motekulo/prog1/README.md

# Prog1

A [guitar pedal](https://progpedals.com.au/pedals/) that runs patches prototyped on a Daisy Pod. 

[ProgPedals](https://progpedals.com.au) is the site dedicated to this pedal, patches, and community.

## Thanks

- For hardware thanks to work on the Dasiy Petal, the [Terrarium](https://www.pedalpcb.com/product/pcb351/), [Hothouse](https://clevelandmusicco.com/hothouse-diy-digital-signal-processing-platform-kit/) and the work of  [Keith Shepherd](https://github.com/bkshepherd)
- Timothy Schoen and other developers (Alex Mitchell, for example) for Plugdata
- Wasted Audio for the [Heavy hvcc compiler](https://wasted-audio.github.io/hvcc/)
- Graham Wakefield and Gregory Taylor for [Generating Sound and Organizing Time](https://cycling74.com/books/go)

## Videos

[ProgPedals playlist](https://www.youtube.com/playlist?list=PL_tHhignqT_7VD3HtruWB_GTngK06rujz)

## Roadmap

- Prog2 - using the [Daisy Seed2 DFM](https://electro-smith.com/pages/daisy-seed2-dfm)
- ~~ Footswitch PCBs connected via IDC cable ~~
- ~~ Better audio sockets ~~
- ~~ SMD version as well as through hole. ~~

## About me
I'm a musician/ lecturer - https://researchers.mq.edu.au/en/persons/denis-crowdy, https://codemusic.studio
