motekulo/prog1/hardware/3dmodels/3-D NMJ6HCD2.stp

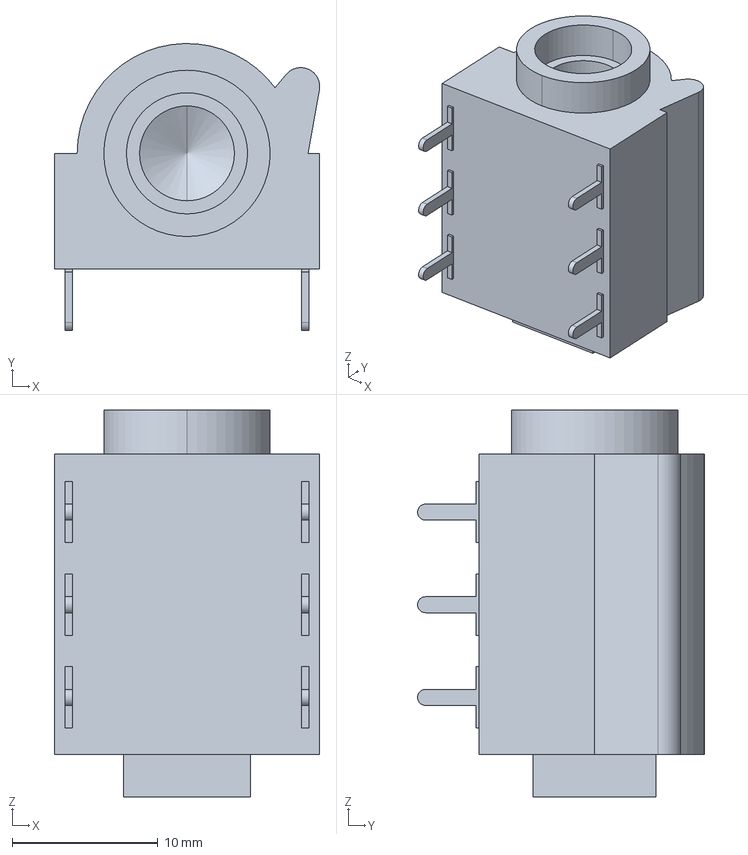
[picture p1: CAD file, 2025-10-05]
hardware/3dmodels/3-D NMJ6HCD2.stp
18.2 x 19.7 x 26.5 mm
