motekulo/prog1/hardware/footprints/stereo_socket/NYS215/3D/NYS215.stp

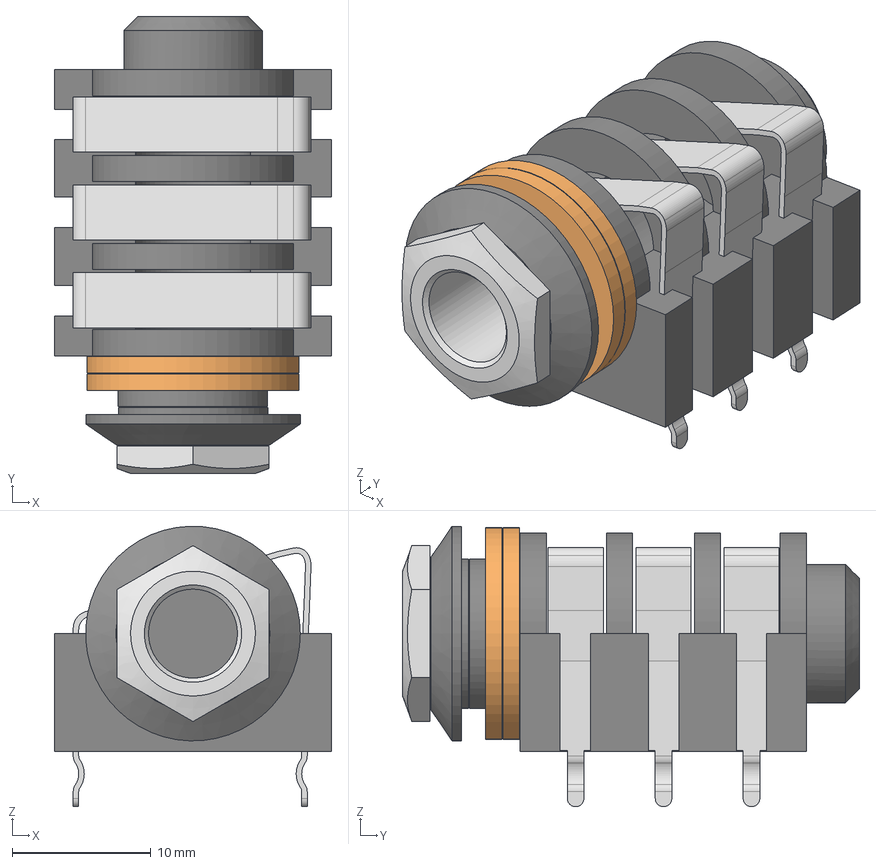
[picture p2: CAD file, 2025-10-05]
hardware/footprints/stereo_socket/NYS215/3D/NYS215.stp
20.0 x 33.0 x 20.2 mm
