motekulo/prog1/hardware/footprints/stompdpdt/SF12011F-0202-20R-M-050/3D/SF12011F-0202-20R-M-050.stp

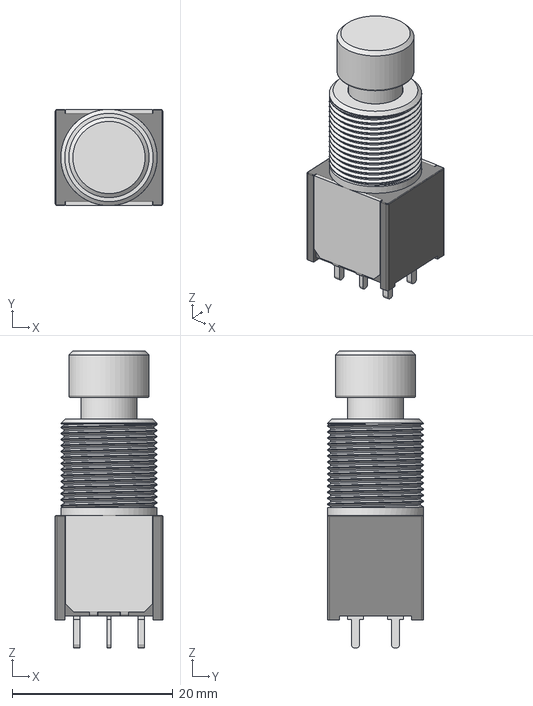
[picture p3: CAD file, 2025-10-04]
hardware/footprints/stompdpdt/SF12011F-0202-20R-M-050/3D/SF12011F-0202-20R-M-050.stp
13.4 x 12.0 x 37.0 mm
