motekulo/prog1/(list of files, cad)

Other CAD files:
hardware/footprints/stereo_socket/NYS215/Allegro/nys215.psm
hardware/footprints/stereo_socket/NYS215/DEHDL/nys215/chips/chips.prt
hardware/footprints/stompdpdt/SF12011F-0202-20R-M-050/Allegro/sf12011f020220rm050.psm
hardware/footprints/stompdpdt/SF12011F-0202-20R-M-050/DEHDL/sf12011f_0202_20r_m_050/chips/chips.prt
