motekulo/prog1/(list of files, drawings)

Other design files:
hardware/footprints/stereo_socket/NYS215/Altium/NYS215.PcbLib
hardware/footprints/stereo_socket/NYS215/Altium/NYS215.SchLib
hardware/footprints/stompdpdt/SF12011F-0202-20R-M-050/Altium/SF12011F020220RM050.PcbLib
hardware/footprints/stompdpdt/SF12011F-0202-20R-M-050/Altium/SF12011F-0202-20R-M-050.SchLib
