motekulo/prog1/hardware/125b/125b.kicad_pcb

## KiCad design hardware/125b/125b.kicad_pcb (2026-09-01)

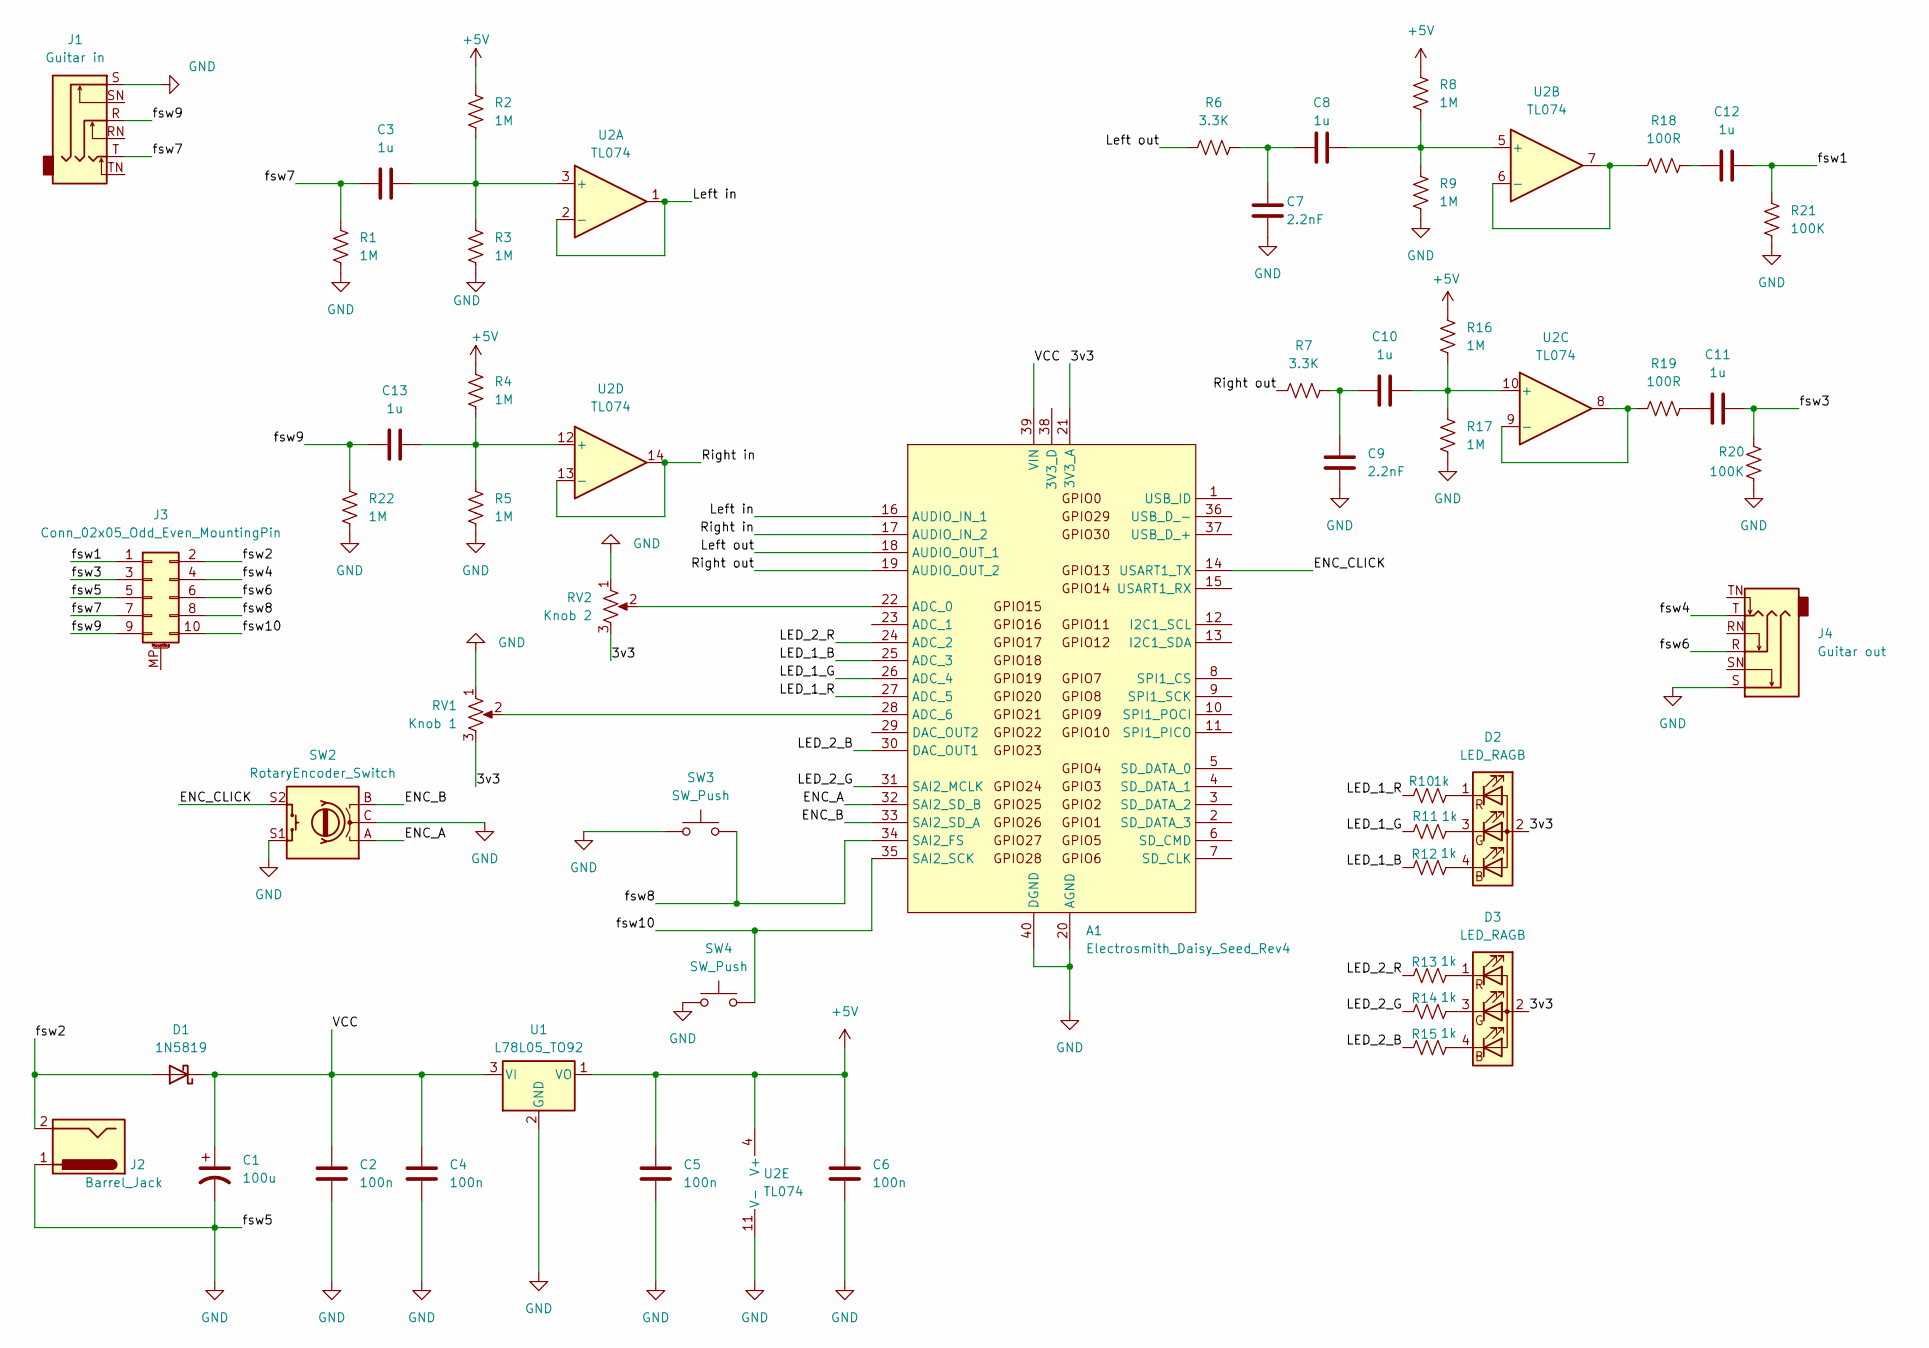
[picture p4: schematic 125b.kicad_sch, Podal]

Parts:
A1: Electrosmith_Daisy_Seed_Rev4; Electrosmith_Daisy_Seed
C1: 100u; C_Radial_D5.0mm_H11.0mm_P2.00mm
C2, C4, C5, C6: 100n; C_0805_2012Metric
C3, C8, C10, C11, C12, C13: 1u; C_0805_2012Metric
C7, C9: 2.2nF; C_0805_2012Metric
D1: 1N5819; D_DO-41_SOD81_P7.62mm_Horizontal
D2, D3: LED_RAGB; LED_D5.0mm-4_RGB_Wide_Pins
J1: Guitar in; Jack_6.35mm_Neutrik_NMJ6HCD2_Horizontal
J2: Barrel_Jack; BarrelJack_Horizontal
J3: Conn_02x05_Odd_Even_MountingPin; IDC-Header_2x05_P2.54mm_Vertical
J4: Guitar out; Jack_6.35mm_Neutrik_NMJ6HCD2_Horizontal
R1, R2, R3, R4, R5, R8, R9, R16, R17, R22: 1M; R_0805_2012Metric
R6, R7: 3.3K; R_0805_2012Metric
R10, R11, R12, R13, R14, R15: 1k; R_0805_2012Metric
R18, R19: 100R; R_0805_2012Metric
R20, R21: 100K; R_0805_2012Metric
RV1: Knob 1; Potentiometer_Alps_RK09K_Single_Vertical
RV2: Knob 2; Potentiometer_Alps_RK09K_Single_Vertical
SW2: RotaryEncoder_Switch; RotaryEncoder_Alps_EC12E-Switch_Vertical_H20mm
SW3, SW4: SW_Push; SolderWire-0.5sqmm_1x02_P4.6mm_D0.9mm_OD2.1mm
U1: L78L05_TO92; TO-92_Inline_Wide_78L05_dc
U2: TL074; SOIC-14_3.9x8.7mm_P1.27mm

Connections:
+5V: C5.2, C6.2, R2.1, R4.1, R8.1, R16.1, U1.1 (VO), U2.4 (V+)
/3v3: A1.21 (3V3_A), D2.2 (A), D3.2 (A), RV1.3, RV2.3
/ENC_A: A1.32 (SAI2_SD_B), SW2.A
/ENC_B: A1.33 (SAI2_SD_A), SW2.B
/ENC_CLICK: A1.14 (USART1_TX), SW2.S2
/LED_1_B: A1.25 (ADC_3), R12.1
/LED_1_G: A1.26 (ADC_4), R11.1
/LED_1_R: A1.27 (ADC_5), R10.1
/LED_2_B: A1.30 (DAC_OUT1), R15.1
/LED_2_G: A1.31 (SAI2_MCLK), R14.1
/LED_2_R: A1.24 (ADC_2), R13.1
/Left in: A1.16 (AUDIO_IN_1), U2.1, U2.2 (-)
/Left out: A1.18 (AUDIO_OUT_1), R6.1
/Right in: A1.17 (AUDIO_IN_2), U2.13 (-), U2.14
/Right out: A1.19 (AUDIO_OUT_2), R7.1
/VCC: A1.39 (VIN), C1.1, C2.2, C4.2, D1.1 (K), U1.3 (VI)
/fsw1: C12.2, J3.1, R21.1
/fsw2: D1.2 (A), J2.2, J3.2
/fsw3: C11.2, J3.3, R20.1
/fsw4: J3.4, J4.T
/fsw6: J3.6, J4.R
/fsw7: C3.1, J1.T, J3.7, R1.1
/fsw8: A1.34 (SAI2_FS), J3.8, SW3.2
/fsw9: C13.1, J1.R, J3.9, R22.1
/fsw10: A1.35 (SAI2_SCK), J3.10, SW4.2
GND: A1.20 (AGND), A1.40 (DGND), C1.2, C2.1, C4.1, C5.1, C6.1, C7.1, C9.1, J1.S, J2.1, J3.5, J4.S, R1.2, R3.2, R5.2, R9.2, R17.2, R20.2, R21.2, R22.2, RV1.1, RV2.1, SW2.C, SW2.S1, SW3.1, SW4.1, U1.2 (GND), U2.11 (V-)
unnamed: A1.22 (ADC_0), RV2.2
unnamed: A1.28 (ADC_6), RV1.2
unnamed: C7.2, C8.1, R6.2
unnamed: C9.2, C10.1, R7.2
unnamed: C11.1, R19.2
unnamed: C12.1, R18.2
unnamed: D2.4 (BK), R12.2
unnamed: D2.3 (GK), R11.2
unnamed: D2.1 (RK), R10.2
unnamed: D3.4 (BK), R15.2
unnamed: D3.3 (GK), R14.2
unnamed: D3.1 (RK), R13.2
unnamed: C3.2, R2.2, R3.1, U2.3 (+)
unnamed: C8.2, R8.2, R9.1, U2.5 (+)
unnamed: R18.1, U2.6 (-), U2.7
unnamed: C10.2, R16.2, R17.1, U2.10 (+)
unnamed: R19.1, U2.8, U2.9 (-)
unnamed: C13.2, R4.2, R5.1, U2.12 (+)

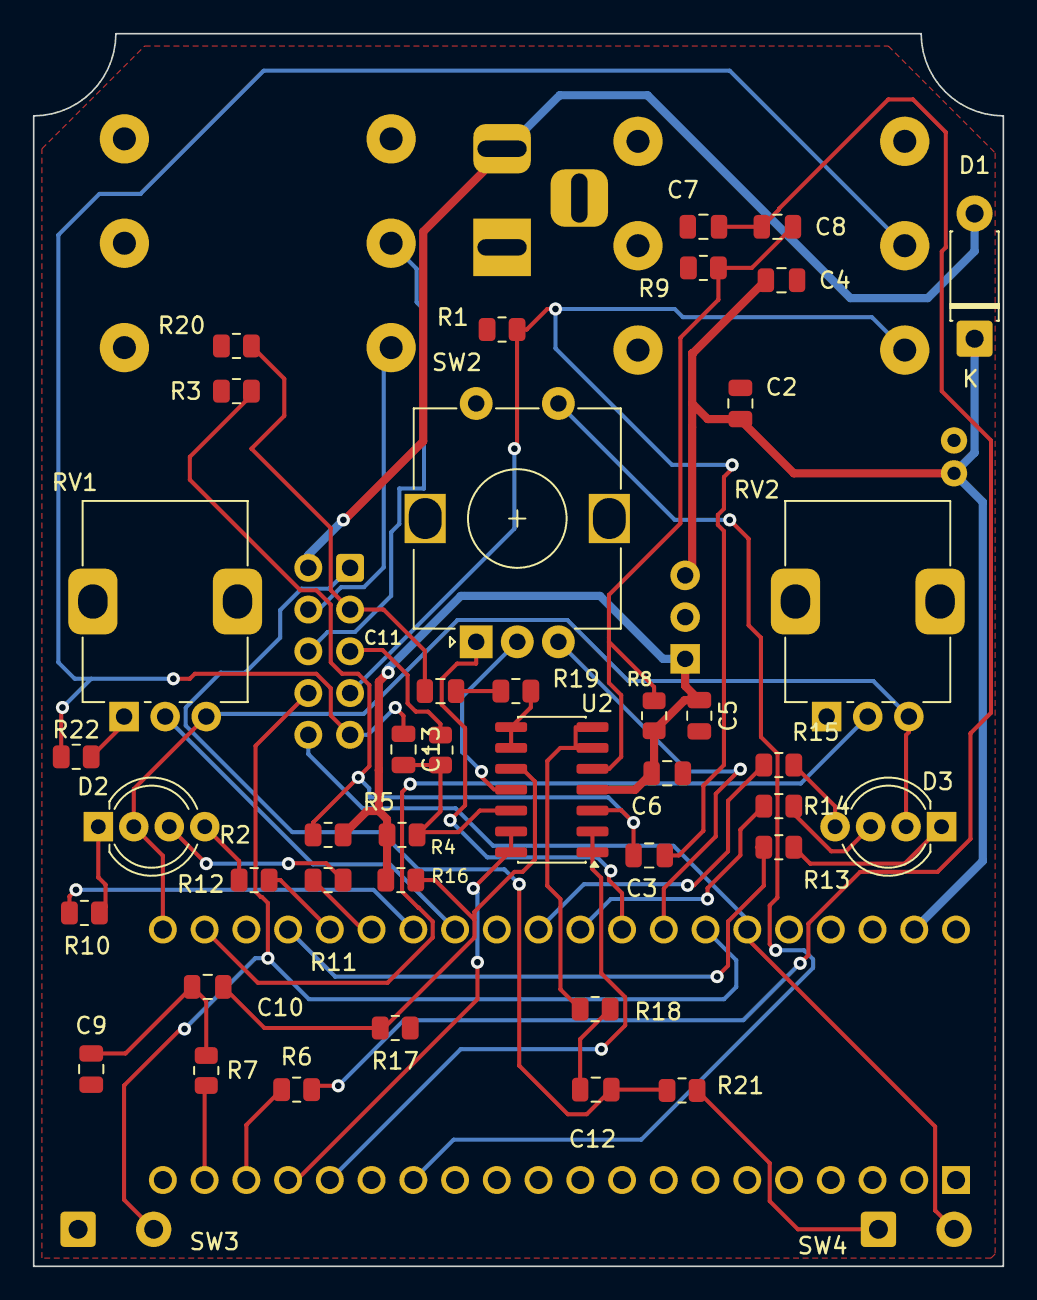
[picture p5: board 125b.kicad_pcb from above]

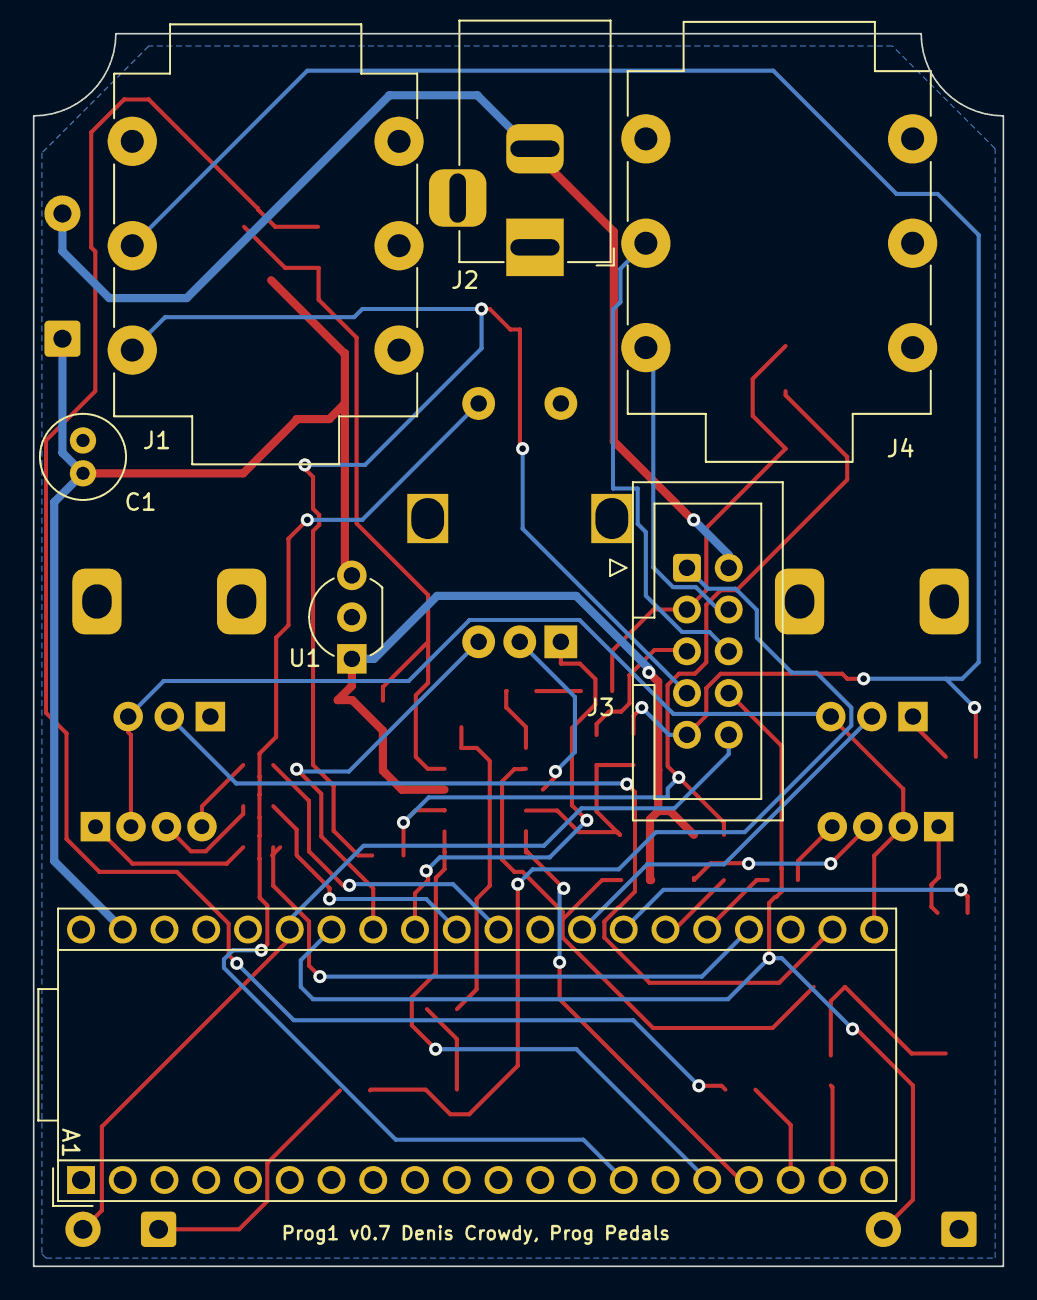
[picture p6: board 125b.kicad_pcb from below]

Board: 2 copper layers, 59.0 x 75.0 mm, 50 parts (7 on the bottom side), 44 nets.
