motekulo/prog1/hardware/footswitch/footswitch.kicad_pcb

## KiCad design hardware/footswitch/footswitch.kicad_pcb (2026-02-12)

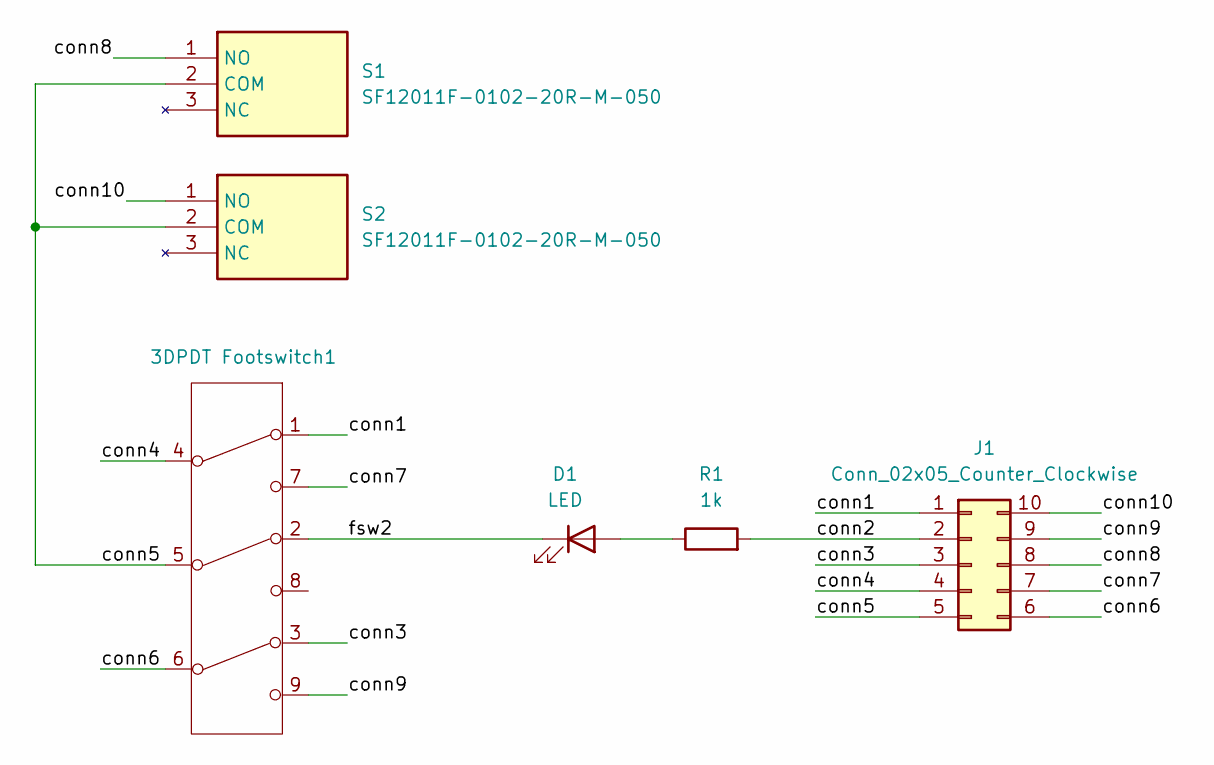
[picture p7: schematic footswitch.kicad_sch, 3DPDT Footswitch board]

Parts:
3DPDT Footswitch1: 0.7 footswitches - 3dpdt tayda
D1: LED; LED_D1.8mm_W3.3mm_H2.4mm
J1: Conn_02x05_Counter_Clockwise; IDC-Header_2x05_P2.54mm_Vertical
R1: 1k; R_Axial_DIN0207_L6.3mm_D2.5mm_P10.16mm_Horizontal
S1, S2: SF12011F-0102-20R-M-050; 0.7 footswitches; Mouser Part Number 107-SF12011F-102-M

Connections:
/conn1: 3DPDT Footswitch1.1 (A), J1.1
/conn2: J1.2, R1.2
/conn3: 3DPDT Footswitch1.3 (C), J1.3
/conn4: 3DPDT Footswitch1.4 (D), J1.4
/conn5: 3DPDT Footswitch1.5 (E), J1.5, S1.2 (COM), S2.2 (COM)
/conn6: 3DPDT Footswitch1.6 (F), J1.6
/conn7: 3DPDT Footswitch1.7 (G), J1.7
/conn8: J1.8, S1.1 (NO)
/conn9: 3DPDT Footswitch1.9 (G), J1.9
/conn10: J1.10, S2.1 (NO)
/fsw2: 3DPDT Footswitch1.2 (B), D1.1 (K)
unnamed: D1.2 (A), R1.1

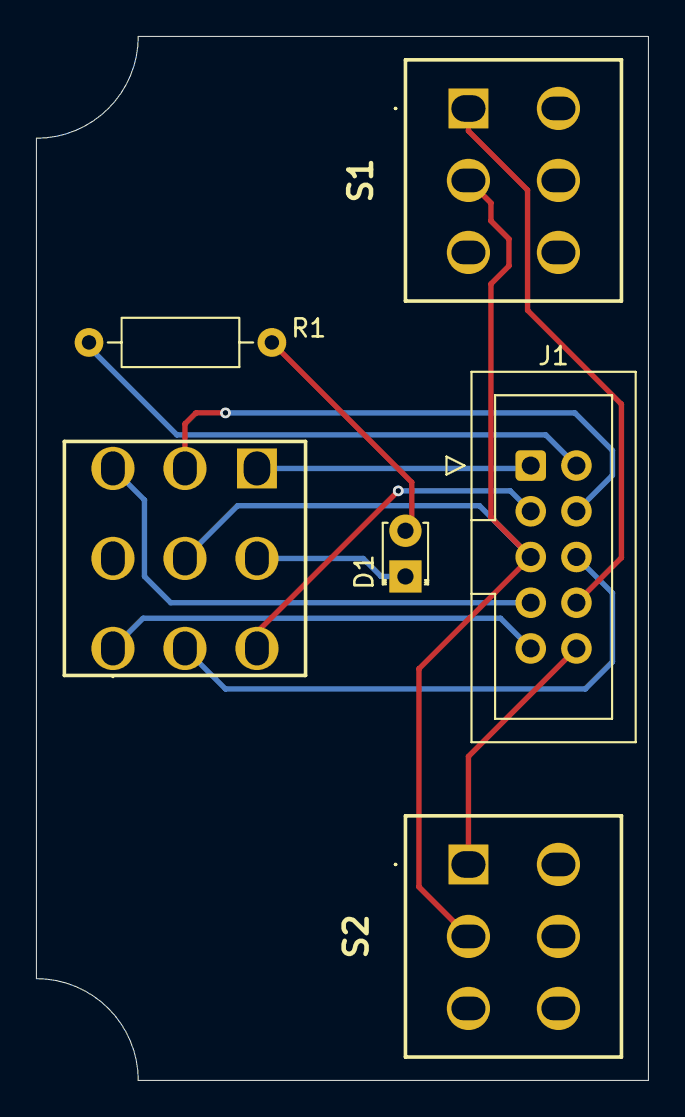
[picture p8: board footswitch.kicad_pcb from above]

Board: 2 copper layers, 34.0 x 58.0 mm, 6 parts (0 on the bottom side), 12 nets.
