motekulo/prog1/(commit log)

2025-10-02 Thinner neutrik audio sockets
    ALlows power socket to move to back of board again
    [125b.kicad_pcb, 125b.kicad_sch]
2025-10-02 Get everything connected
    [125b.kicad_pcb]
2025-10-02 Tiday up references on board and move c1
    [125b.kicad_pcb]
2025-10-03 Trace and component adjustments
    Also add local footprints
    [125b.kicad_pcb]
2025-10-03 Track adjustments to footswitch board
    [footswitch.kicad_pcb]
2025-10-04 Adjust footprint for dpdt alpha
    [EDI2CAP.CFG, SF12011F-0202-20R-M-050.SchLib, SF12011F-0202-20R-M-050.stp, SF12011F020220RM050.PcbLib, chips.prt, footswitch.kicad_pcb, footswitch.kicad_sch, sf12011f020220rm050.psm]
2025-10-05 Add footprints and 3d model
    [125b.kicad_pcb, 3-D NMJ6HCD2.stp, EDI2CAP.CFG, NYS215.PcbLib, NYS215.SchLib, NYS215.stp, chips.prt, nys215.psm]
2025-10-05 Name change from Crouds to Prog1 on PCB
    [125b.kicad_pcb]
2025-10-05 Move some labels
    [125b.kicad_pcb]
2025-10-07 Move resistor so switch sections could be cut off
    Might want a different switch connected directly to main pcb
    [footswitch.kicad_pcb]
2025-10-16 Add user drawings for pot and switch spindles
    Also LED on footswitch
    [125b.kicad_pcb, footswitch.kicad_pcb]
2025-10-16 Add drill template file for 0.6
    Incomplete
2025-10-16 Align drill holes, adjust d3 y pos
    Labels on separate layer
2025-11-03 Fix line in switch footprint and update pcb
    [125b.kicad_pcb]
2025-11-03 Rotate the audio sockets (and correct the 3d model orientation)
    [125b.kicad_pcb]
2025-11-03 Update version number on board
    [125b.kicad_pcb]
2025-11-03 Reconnect, adjust some positions, and tweak
    [125b.kicad_pcb]
2025-11-03 Put D2 and D3 in same y position
    [125b.kicad_pcb]
2025-11-03 Bevel bottom corners of footswitch board to fit 125b corners
    [footswitch.kicad_pcb]
2025-11-03 Adjust footprints for Tayda compact footswitches
    [footswitch.kicad_pcb, footswitch.kicad_sch]
2025-11-04 Remove line in switch - TL074 is fine
    [125b.kicad_pcb, 125b.kicad_sch, footswitch.kicad_pcb]
2025-11-04 Minor tweaks and checks to footswitch
    [footswitch.kicad_pcb]
2025-11-05 Tidy up labels on main pcb
    [125b.kicad_pcb, 125b.kicad_sch, footswitch.kicad_pcb]
2025-11-24 Fix pad nums on 3dpdt footprint and rotate on board
    [footswitch.kicad_pcb]
2026-02-12 Add Blooming Sparkles patch
    [footswitch.kicad_pcb]
2026-08-16 Add stereo input to schematic and start pcb changes
    [125b.kicad_pcb, 125b.kicad_sch]
2026-09-01 Add binary of breaks
    [125b.kicad_pcb]
